isaacdb/Projeto-NATCAR/README.md

# Robô Seguidor de linha NATCAR

<p align="center">Projeto desenvolvido em 2019 para a competição NATCAR da Faculdade SATC</p>

## 💻 Sobre o projeto
<p>Para a inteligência do robô foi implementado o controlador proporcional integral derivativo (PID), proporcionando a rápida adaptação e tomada de decisão ao longo de todos os percursos, percursos estes que são desconhecidos do robô até o momento da partida. Foi nítida a dificuldade de se encontrar um valor de equilíbrio para as condições de trabalho do controlador, porem quando feito, o resultado se mostra de enorme qualidade!</p>

<p>Video do robô utilizando controle PID: https://youtu.be/_9ziKsXKdWg</p>

---

### Features

- [x] Arduino Uno R3
- [x] Barra de Sensores Analógicos
- [x] Controle PID

### 🛠 Tecnologias

As seguintes ferramentas foram usadas na construção do projeto:

- [IDE Arduino]
- [C++]

### Autor do código
Isaac Debiasi
